CarsonDecapod/Loom_RP2040_Euro/RP2040_Euro_Power.kicad_pcb

## KiCad design RP2040_Euro_Power.kicad_pcb (2025-02-09)

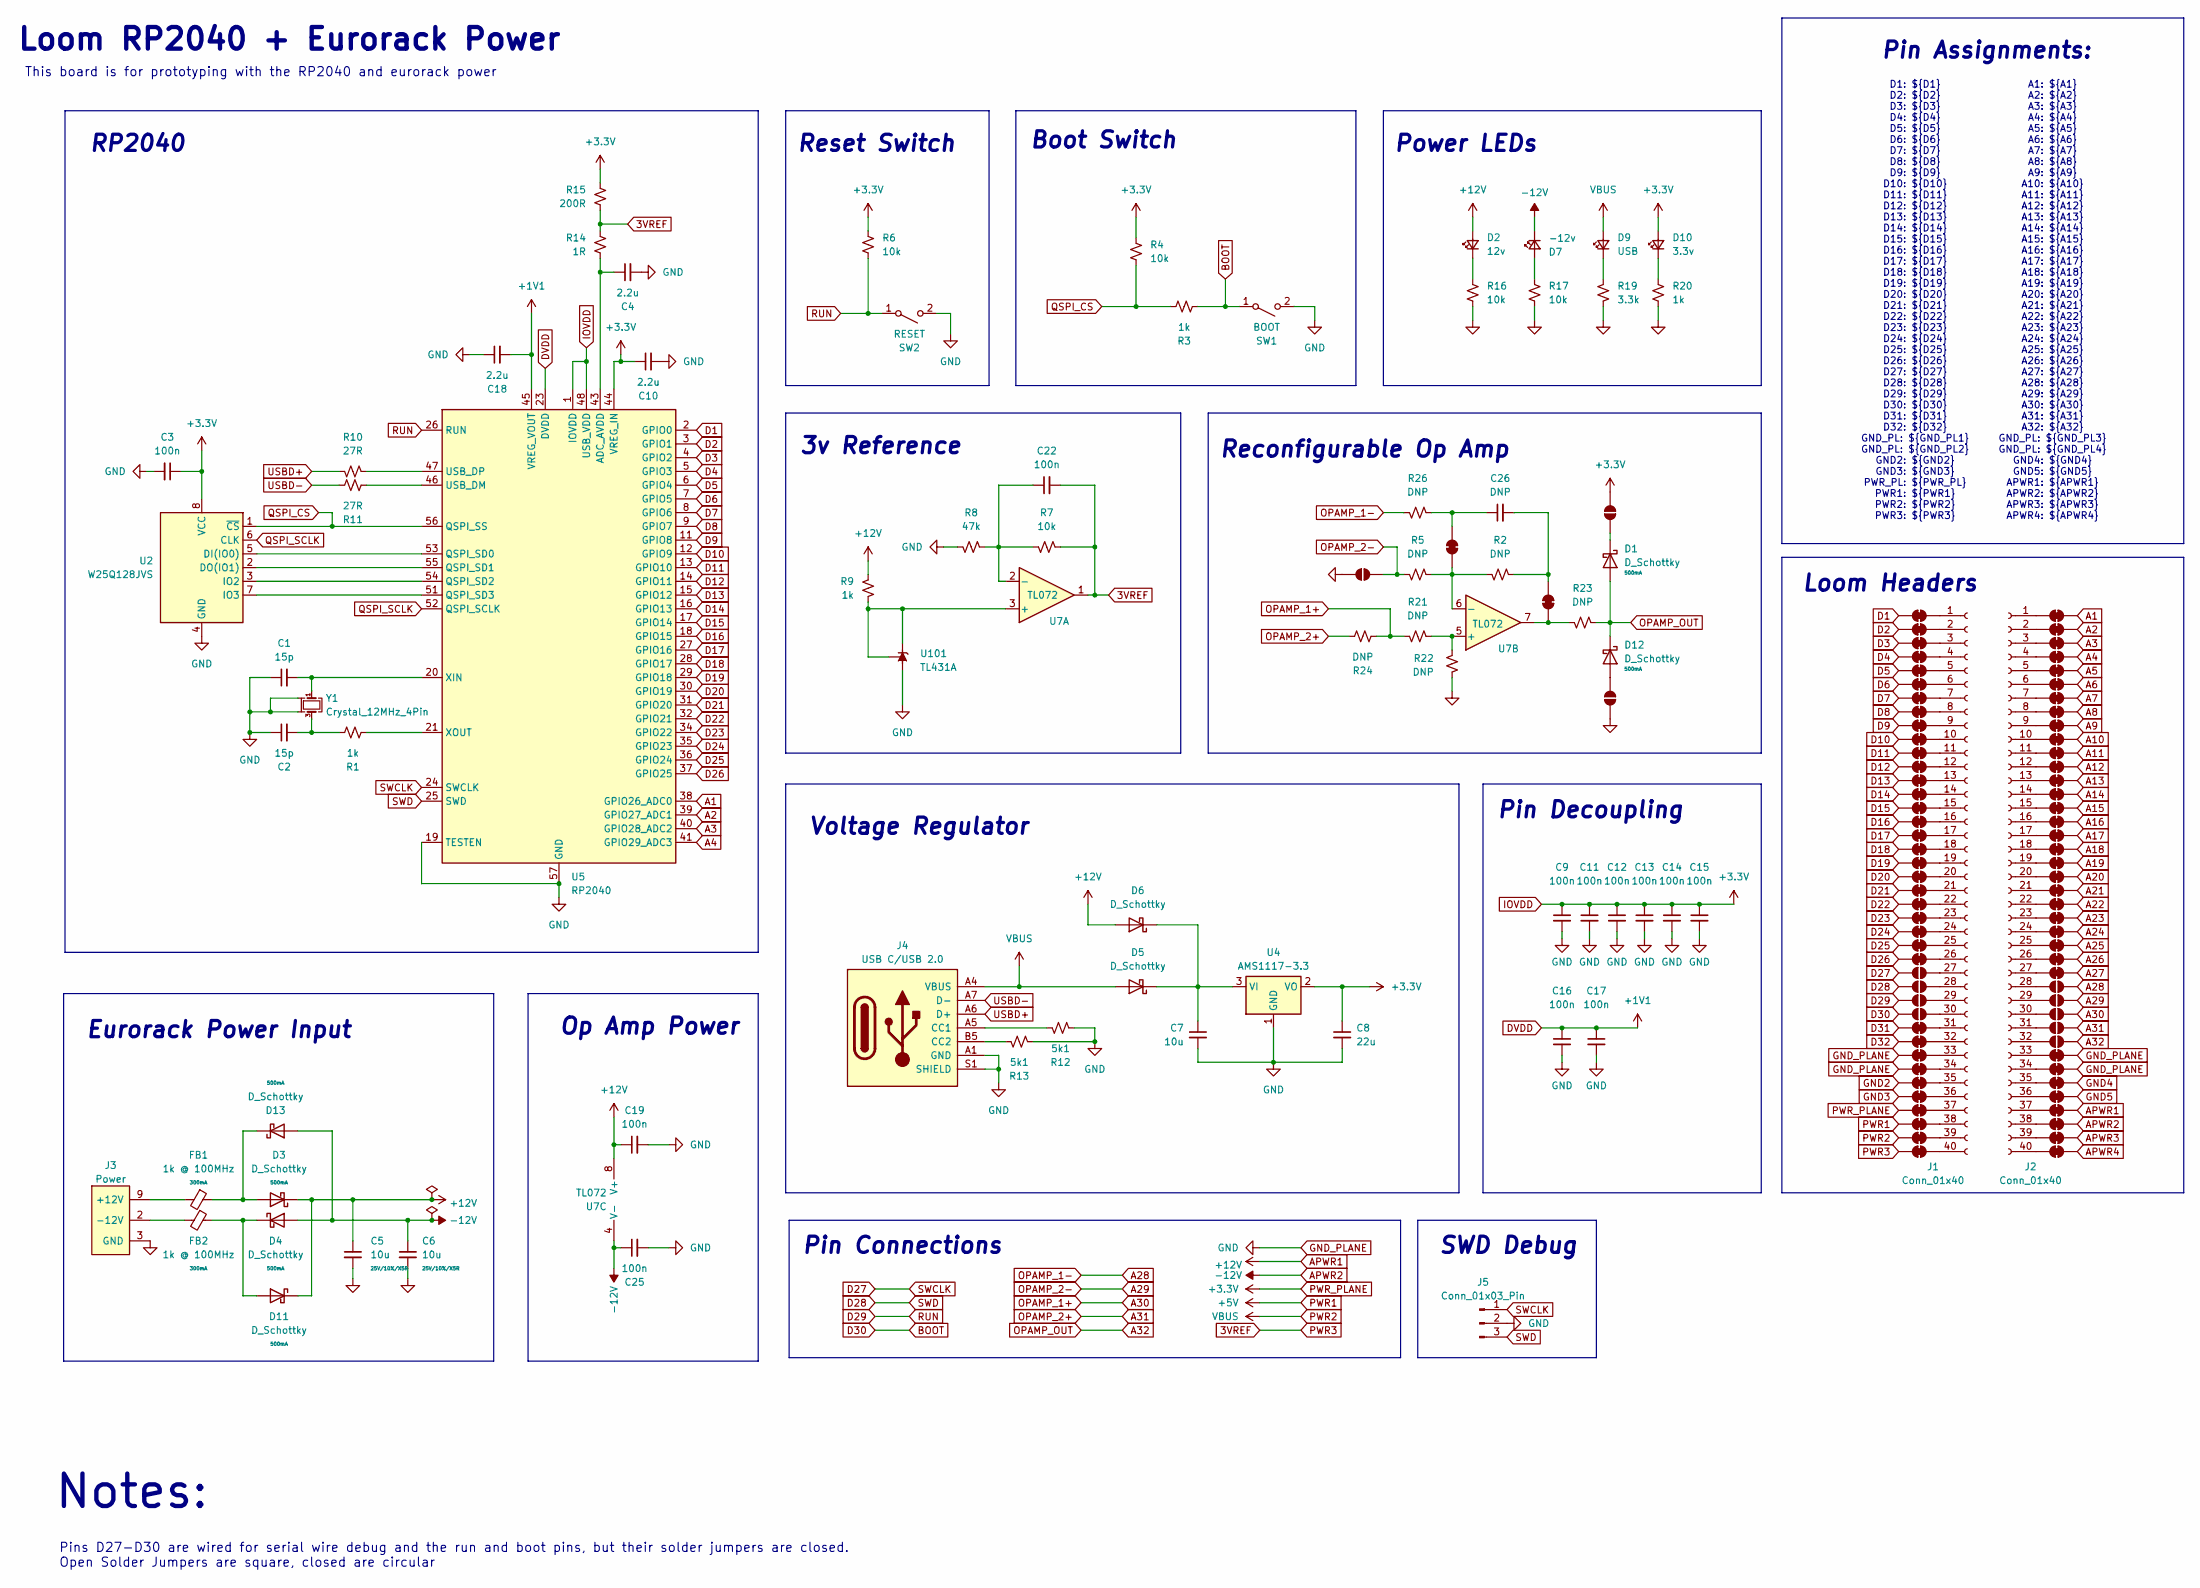
[picture p1: schematic RP2040_Euro_Power.kicad_sch]

Parts:
C1, C2: 15p; C_0603_HandSolder; Rating 25V/10%/C0G; MPN CL10C150JB8NNNC; LCSC C1644
C3, C9, C11, C12, C13, C14, C15, C16, C17, C19, C22, C25: 100n; C_0603_HandSolder; Rating 25V/10%/C0G; MPN CC0603KRX7R9BB104; LCSC C14663
C4, C10, C18: 2.2u; C_0603_HandSolder; Rating 25V/10%/C0G; MPN CL10A225KO8NNNC; LCSC C23630
C5, C6: 10u; C_0805_HandSolder; Rating 25V/10%/X5R; MPN CL21A106KAYNNNE; DigiKey 490-16824-1-ND
C7: 10u; C_0805_HandSolder; Rating 25V/10%/C0G; MPN CL21A106KAYNNNE; LCSC C15850
C8: 22u; C_0805_HandSolder; Rating 25V/10%/C0G; MPN CL21A226MAQNNNE; LCSC C45783
C26: DNP; C_0603_HandSolder; Rating 25V/10%; mpn C1608X7R1E104K080AA
D1, D3, D4, D11, D12, D13: D_Schottky; D_SMA; Rating 500mA; MPN SS14; DigiKey 1727-3876-1-ND
D2: 12v; LED_0805_2012Metric; MPN KT-0805G; LCSC C2297
D5, D6: D_Schottky; D_SMA; MPN SS14; LCSC C2480
D7: -12v; LED_0805_2012Metric; MPN KT-0805G; LCSC C2297
D9: USB; LED_0805_2012Metric; MPN KT-0805G; LCSC C2297
D10: 3.3v; LED_0805_2012Metric; MPN KT-0805G; LCSC C2297
FB1, FB2: 1k @ 100MHz; L_0603_HandSolder; Rating 300mA; MPN GZ1608D601TF; DigiKey 490-5212-1-ND
J1, J2: Conn_01x40; PinHeader_1x40_P2.54mm_Vertical
J3: Power; Eurorack_Power_2x5_Shrouded_Lock_LongPads; MPN 302-S101
J4: USB C/USB 2.0; USB_C_Receptacle_GCT_USB4105-xx-A_16P_TopMnt_Horizontal; MPN TYPE-C 16PIN 2MD(073); LCSC C2765186
J5: Conn_01x03_Pin; PinHeader_1x03_P2.54mm_Vertical
JP1, JP201: Jumper_Closed; SolderJumper-2_P1.3mm_Bridged_RoundedPad1.0x1.5mm
JP2, JP3, JP4, JP127, JP128, JP129, JP130, JP168, JP169, JP170, JP171, JP172: SolderJumper_2_Open; SolderJumper-2_P1.3mm_Open_Pad1.0x1.5mm
JP101, JP102, JP103, JP104, JP105, JP106, JP107, JP108, JP109, JP110, JP111, JP112, JP113, JP114, JP115, JP116, JP117, JP118, JP119, JP120, JP121, JP122, JP123, JP124, JP125, JP126, JP131, JP132, JP133, JP134, JP135, JP136, JP137, JP138, JP139, JP140, JP141, JP142, JP143, JP144, JP145, JP146, JP147, JP148, JP149, JP150, JP151, JP152, JP153, JP154, JP155, JP156, JP157, JP158, JP159, JP160, JP161, JP162, JP163, JP164, JP165, JP166, JP167, JP173, JP174, JP175, JP176, JP177, JP178, JP179, JP180: SolderJumper-2_P1.3mm_Bridged_RoundedPad1.0x1.5mm
R1, R3, R9, R20: 1k; R_0603_HandSolder; Rating 100mW/1%/Thin; MPN 0603WAF1001T5E; LCSC C21190
R2, R5, R21, R22, R23, R24, R26: DNP; R_0603_HandSolder; Rating 100mW/1%/Thin
R4, R6, R7, R16, R17: 10k; R_0603_HandSolder; Rating 100mW/1%/Thin; MPN 0603WAF1002T5E; LCSC C25804
R8: 47k; R_0603_HandSolder; Rating 100mW/1%/Thin; MPN 0603WAF4702T5E; LCSC C25819
R10, R11: 27R; R_0603_HandSolder; Rating 100mW/1%/Thin; MPN 0603WAF270JT5E; LCSC C25190
R12, R13: 5k1; R_0603_HandSolder; Rating 100mW/1%/Thin; MPN 0603WAF5101T5E; LCSC C23186
R14: 1R; R_0603_HandSolder; Rating 100mW/1%/Thin; MPN 0603WAF100KT5E; LCSC C22936
R15: 200R; R_0603_HandSolder; Rating 100mW/1%/Thin; MPN 0603WAF2000T5E; LCSC C8218
R19: 3.3k; R_0603_HandSolder; Rating 100mW/1%/Thin; MPN 0603WAF3301T5E; LCSC C22978
SW1: BOOT; SW-SMD_TS24CA; MPN TS24CA; LCSC C393942
SW2: RESET; SW-SMD_TS24CA; MPN TS24CA; LCSC C393942
U2: W25Q128JVS; SOIC-8_5.23x5.23mm_P1.27mm; MPN W25Q128JVSIQ; LCSC C97521
U4: AMS1117-3.3; SOT-223-3_TabPin2; MPN AMS1117-3.3; LCSC C6186
U5: RP2040; QFN-56-1EP_7x7mm_P0.4mm_EP3.2x3.2mm; MPN RP2040; LCSC C2040
U7: TL072; SOIC-8_3.9x4.9mm_P1.27mm; MPN TL072CDT; LCSC C6961
U101: TL431A; SOT-23; Rating 1%; MPN TL431BSA-7, TL431AQDBZR,215;; DigiKey 1727-4260-1-ND
Y1: Crystal_12MHz_4Pin; Crystal_SMD_Abracon_ABM8G-4Pin_3.2x2.5mm; MPN ABM8-272-T3; LCSC C20625731

Connections:
3VREF: C22.2, JP140.2 (B), R7.2, R14.1, R15.2, U7.1
A1: JP141.1 (A), U5.38 (GPIO26_ADC0)
A2: JP142.1 (A), U5.39 (GPIO27_ADC1)
A3: JP143.1 (A), U5.40 (GPIO28_ADC2)
A4: JP144.1 (A), U5.41 (GPIO29_ADC3)
A5: JP145.1 (A)
A6: JP146.1 (A)
A7: JP147.1 (A)
A8: JP148.1 (A)
A9: JP149.1 (A)
A10: JP150.1 (A)
A11: JP151.1 (A)
A12: JP152.1 (A)
A13: JP153.1 (A)
A14: JP154.1 (A)
A15: JP155.1 (A)
A16: JP156.1 (A)
A17: JP157.1 (A)
A18: JP158.1 (A)
A19: JP159.1 (A)
A20: JP160.1 (A)
A21: JP161.1 (A)
A22: JP162.1 (A)
A23: JP163.1 (A)
A24: JP164.1 (A)
A25: JP165.1 (A)
A26: JP166.1 (A)
A27: JP167.1 (A)
A28: JP168.2 (B), R26.1
A29: JP2.2 (B), JP169.2 (B), R5.1
A30: JP170.2 (B), R21.1, R24.2
A31: JP171.2 (B), R24.1
A32: D1.2 (A), D12.1 (K), JP172.2 (B), R23.2
APWR1: C5.1, C19.1, D2.2 (A), D3.1 (K), D6.2 (A), D11.1 (K), JP177.1 (A), R9.1, U7.8 (V+)
APWR2: C6.1, C25.1, D4.2 (A), D7.1 (K), D13.2 (A), JP178.1 (A), U7.4 (V-)
APWR3: JP179.1 (A)
APWR4: JP180.1 (A)
BOOT: JP130.1 (A), R3.2, SW1.1 (A)
D1: JP101.2 (B), U5.2 (GPIO0)
D2: JP102.2 (B), U5.3 (GPIO1)
D3: JP103.2 (B), U5.4 (GPIO2)
D4: JP104.2 (B), U5.5 (GPIO3)
D5: JP105.2 (B), U5.6 (GPIO4)
D6: JP106.2 (B), U5.7 (GPIO5)
D7: JP107.2 (B), U5.8 (GPIO6)
D8: JP108.2 (B), U5.9 (GPIO7)
D9: JP109.2 (B), U5.11 (GPIO8)
D10: JP110.2 (B), U5.12 (GPIO9)
D11: JP111.2 (B), U5.13 (GPIO10)
D12: JP112.2 (B), U5.14 (GPIO11)
D13: JP113.2 (B), U5.15 (GPIO12)
D14: JP114.2 (B), U5.16 (GPIO13)
D15: JP115.2 (B), U5.17 (GPIO14)
D16: JP116.2 (B), U5.18 (GPIO15)
D17: JP117.2 (B), U5.27 (GPIO16)
D18: JP118.2 (B), U5.28 (GPIO17)
D19: JP119.2 (B), U5.29 (GPIO18)
D20: JP120.2 (B), U5.30 (GPIO19)
D21: JP121.2 (B), U5.31 (GPIO20)
D22: JP122.2 (B), U5.32 (GPIO21)
D23: JP123.2 (B), U5.34 (GPIO22)
D24: JP124.2 (B), U5.35 (GPIO23)
D25: JP125.2 (B), U5.36 (GPIO24)
D26: JP126.2 (B), U5.37 (GPIO25)
D27: J5.1, JP127.1 (A), U5.24 (SWCLK)
D28: J5.3, JP128.1 (A), U5.25 (SWD)
D29: JP129.1 (A), R6.1, SW2.1 (A), U5.26 (RUN)
D31: JP131.2 (B)
D32: JP132.2 (B)
DVDD: C16.1, C17.1, C18.2, U5.23 (DVDD), U5.45 (VREG_VOUT), U5.50 (DVDD)
GND2: JP135.2 (B)
GND3: JP136.2 (B)
GND4: JP175.1 (A)
GND5: JP176.1 (A)
GND_PLANE: C1.1, C2.1, C3.2, C4.2, C5.2, C6.2, C7.2, C8.2, C9.2, C10.2, C11.2, C12.2, C13.2, C14.2, C15.2, C16.2, C17.2, C18.1, C19.2, C25.2, J3.3 (GND), J3.4 (GND), J3.5 (GND), J3.6 (GND), J3.7 (GND), J3.8 (GND), J4.A1 (GND), J4.A12 (GND), J4.B1 (GND), J4.B12 (GND), J4.S1 (SHIELD), J5.2, JP2.1 (A), JP4.1 (A), JP133.2 (B), JP134.2 (B), JP173.1 (A), JP174.1 (A), R8.1, R12.2, R13.2, R16.1, R17.1, R19.2, R20.2, R22.1, SW1.2 (B), SW2.2 (B), U2.4 (GND), U4.1 (GND), U5.19 (TESTEN), U5.57 (GND), U101.3 (A), Y1.2, Y1.4
IOVDD: C3.1, C8.1, C9.1, C10.1, C11.1, C12.1, C13.1, C14.1, C15.1, D10.2 (A), JP3.2 (B), JP137.2 (B), R4.2, R6.2, R15.1, U2.8 (VCC), U4.2 (VO), U5.1 (IOVDD), U5.10 (IOVDD), U5.22 (IOVDD), U5.33 (IOVDD), U5.42 (IOVDD), U5.44 (VREG_IN), U5.48 (USB_VDD), U5.49 (IOVDD)
unnamed: C2.2, R1.1, Y1.3
unnamed: D1.1 (K), JP3.1 (A)
unnamed: D2.1 (K), R16.2
unnamed: C7.1, D5.1 (K), D6.1 (K), U4.3 (VI)
unnamed: D7.2 (A), R17.2
unnamed: D9.1 (K), R19.1
unnamed: D10.1 (K), R20.1
unnamed: D4.1 (K), D11.2 (A), FB2.1
unnamed: D12.2 (A), JP4.2 (B)
unnamed: D3.2 (A), D13.1 (K), FB1.1
unnamed: FB1.2, J3.9 (+12V), J3.10 (+12V)
unnamed: FB2.2, J3.1 (-12V), J3.2 (-12V)
unnamed: J1.1, JP101.1 (A)
unnamed: J1.2, JP102.1 (A)
unnamed: J1.3, JP103.1 (A)
unnamed: J1.4, JP104.1 (A)
unnamed: J1.5, JP105.1 (A)
unnamed: J1.6, JP106.1 (A)
unnamed: J1.7, JP107.1 (A)
unnamed: J1.8, JP108.1 (A)
unnamed: J1.9, JP109.1 (A)
unnamed: J1.10, JP110.1 (A)
unnamed: J1.11, JP111.1 (A)
unnamed: J1.12, JP112.1 (A)
unnamed: J1.13, JP113.1 (A)
unnamed: J1.14, JP114.1 (A)
unnamed: J1.15, JP115.1 (A)
unnamed: J1.16, JP116.1 (A)
unnamed: J1.17, JP117.1 (A)
unnamed: J1.18, JP118.1 (A)
unnamed: J1.19, JP119.1 (A)
unnamed: J1.20, JP120.1 (A)
unnamed: J1.21, JP121.1 (A)
unnamed: J1.22, JP122.1 (A)
unnamed: J1.23, JP123.1 (A)
unnamed: J1.24, JP124.1 (A)
unnamed: J1.25, JP125.1 (A)
unnamed: J1.26, JP126.1 (A)
unnamed: J1.27, JP127.2 (B)
unnamed: J1.28, JP128.2 (B)
unnamed: J1.29, JP129.2 (B)
unnamed: J1.30, JP130.2 (B)
unnamed: J1.31, JP131.1 (A)
unnamed: J1.32, JP132.1 (A)
unnamed: J1.33, JP133.1 (A)
unnamed: J1.34, JP134.1 (A)
unnamed: J1.35, JP135.1 (A)
unnamed: J1.36, JP136.1 (A)
unnamed: J1.37, JP137.1 (A)
unnamed: J1.38, JP138.1 (A)
unnamed: J1.39, JP139.1 (A)
unnamed: J1.40, JP140.1 (A)
unnamed: J2.1, JP141.2 (B)
unnamed: J2.2, JP142.2 (B)
unnamed: J2.3, JP143.2 (B)
unnamed: J2.4, JP144.2 (B)
unnamed: J2.5, JP145.2 (B)
unnamed: J2.6, JP146.2 (B)
unnamed: J2.7, JP147.2 (B)
unnamed: J2.8, JP148.2 (B)
unnamed: J2.9, JP149.2 (B)
unnamed: J2.10, JP150.2 (B)
unnamed: J2.11, JP151.2 (B)
unnamed: J2.12, JP152.2 (B)
unnamed: J2.13, JP153.2 (B)
unnamed: J2.14, JP154.2 (B)
unnamed: J2.15, JP155.2 (B)
unnamed: J2.16, JP156.2 (B)
unnamed: J2.17, JP157.2 (B)
unnamed: J2.18, JP158.2 (B)
unnamed: J2.19, JP159.2 (B)
unnamed: J2.20, JP160.2 (B)
unnamed: J2.21, JP161.2 (B)
unnamed: J2.22, JP162.2 (B)
unnamed: J2.23, JP163.2 (B)
unnamed: J2.24, JP164.2 (B)
unnamed: J2.25, JP165.2 (B)
unnamed: J2.26, JP166.2 (B)
unnamed: J2.27, JP167.2 (B)
unnamed: J2.28, JP168.1 (A)
unnamed: J2.29, JP169.1 (A)
unnamed: J2.30, JP170.1 (A)
unnamed: J2.31, JP171.1 (A)
unnamed: J2.32, JP172.1 (A)
unnamed: J2.33, JP173.2 (B)
unnamed: J2.34, JP174.2 (B)
unnamed: J2.35, JP175.2 (B)
unnamed: J2.36, JP176.2 (B)
unnamed: J2.37, JP177.2 (B)
unnamed: J2.38, JP178.2 (B)
unnamed: J2.39, JP179.2 (B)
unnamed: J2.40, JP180.2 (B)
unnamed: J4.A5 (CC1), R12.1
unnamed: J4.B5 (CC2), R13.1
unnamed: JP1.1 (A), R2.1, R5.2, U7.6 (-)
unnamed: C26.1, JP1.2 (B), R26.2
unnamed: JP201.1 (A), R23.1, U7.7
unnamed: C26.2, JP201.2 (B), R2.2
unnamed: U2.5 (DI(IO0)), U5.53 (QSPI_SD0)
unnamed: U2.2 (DO(IO1)), U5.55 (QSPI_SD1)
unnamed: U2.3 (IO2), U5.54 (QSPI_SD2)
unnamed: U2.7 (IO3), U5.51 (QSPI_SD3)
unnamed: C4.1, R14.2, U5.43 (ADC_AVDD)
unnamed: R11.1, U5.46 (USB_DM)
unnamed: R10.1, U5.47 (USB_DP)
unnamed: C1.2, U5.20 (XIN), Y1.1
unnamed: R1.2, U5.21 (XOUT)
unnamed: C22.1, R7.1, R8.2, U7.2 (-)
unnamed: R21.2, R22.2, U7.5 (+)
unnamed: R9.2, U7.3 (+), U101.1 (K), U101.2 (REF)
PWR1: JP138.2 (B)
PWR2: D5.2 (A), D9.2 (A), J4.A4 (VBUS), J4.A9 (VBUS), J4.B4 (VBUS), J4.B9 (VBUS), JP139.2 (B)
QSPI_CS: R3.1, R4.1, U2.1 (~CS), U5.56 (QSPI_SS)
QSPI_SCLK: U2.6 (CLK), U5.52 (QSPI_SCLK)
USBD+: J4.A6 (D+), J4.B6 (D+), R10.2
USBD-: J4.A7 (D-), J4.B7 (D-), R11.2

Notes on the sheet:
Pin Assignments:
A1: ${A1} A2: ${A2} A3: ${A3} A4: ${A4} A5: ${A5} A6: ${A6} A7: ${A7} A8: ${A8} A9: ${A9} A10: ${A10} A11: ${A11} A12: ${A12} A13: ${A13} A14: ${A14} A15: ${A15} A16: ${A16} A17: ${A17} A18: ${A18} A19: ${A19} A20: ${A20} A21: ${A21} A22: ${A22} A23: ${A23} A24: ${A24} A25: ${A25} A26: ${A26} A27: 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
Loom RP2040 + Eurorack Power
Power LEDs
Notes:
Reconfigurable Op Amp
RP2040
Reset Switch
This board is for prototyping with the RP2040 and eurorack power
D1: ${D1} D2: ${D2} D3: ${D3} D4: ${D4} D5: ${D5} D6: ${D6} D7: ${D7} D8: ${D8} D9: ${D9} D10: ${D10} D11: ${D11} D12: ${D12} D13: ${D13} D14: ${D14} D15: ${D15} D16: ${D16} D17: ${D17} D18: ${D18} D19: ${D19} D20: ${D20} D21: ${D21} D22: ${D22} D23: ${D23} D24: ${D24} D25: ${D25} D26: ${D26} D27: 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
Eurorack Power Input
Pin Decoupling
Voltage Regulator
Loom Headers
SWD Debug
3v Reference
Boot Switch
Op Amp Power
Pins D27-D30 are wired for serial wire debug and the run and boot pins, but their solder jumpers are closed. Open Solder Jumpers are square, closed are circular
Pin Connections

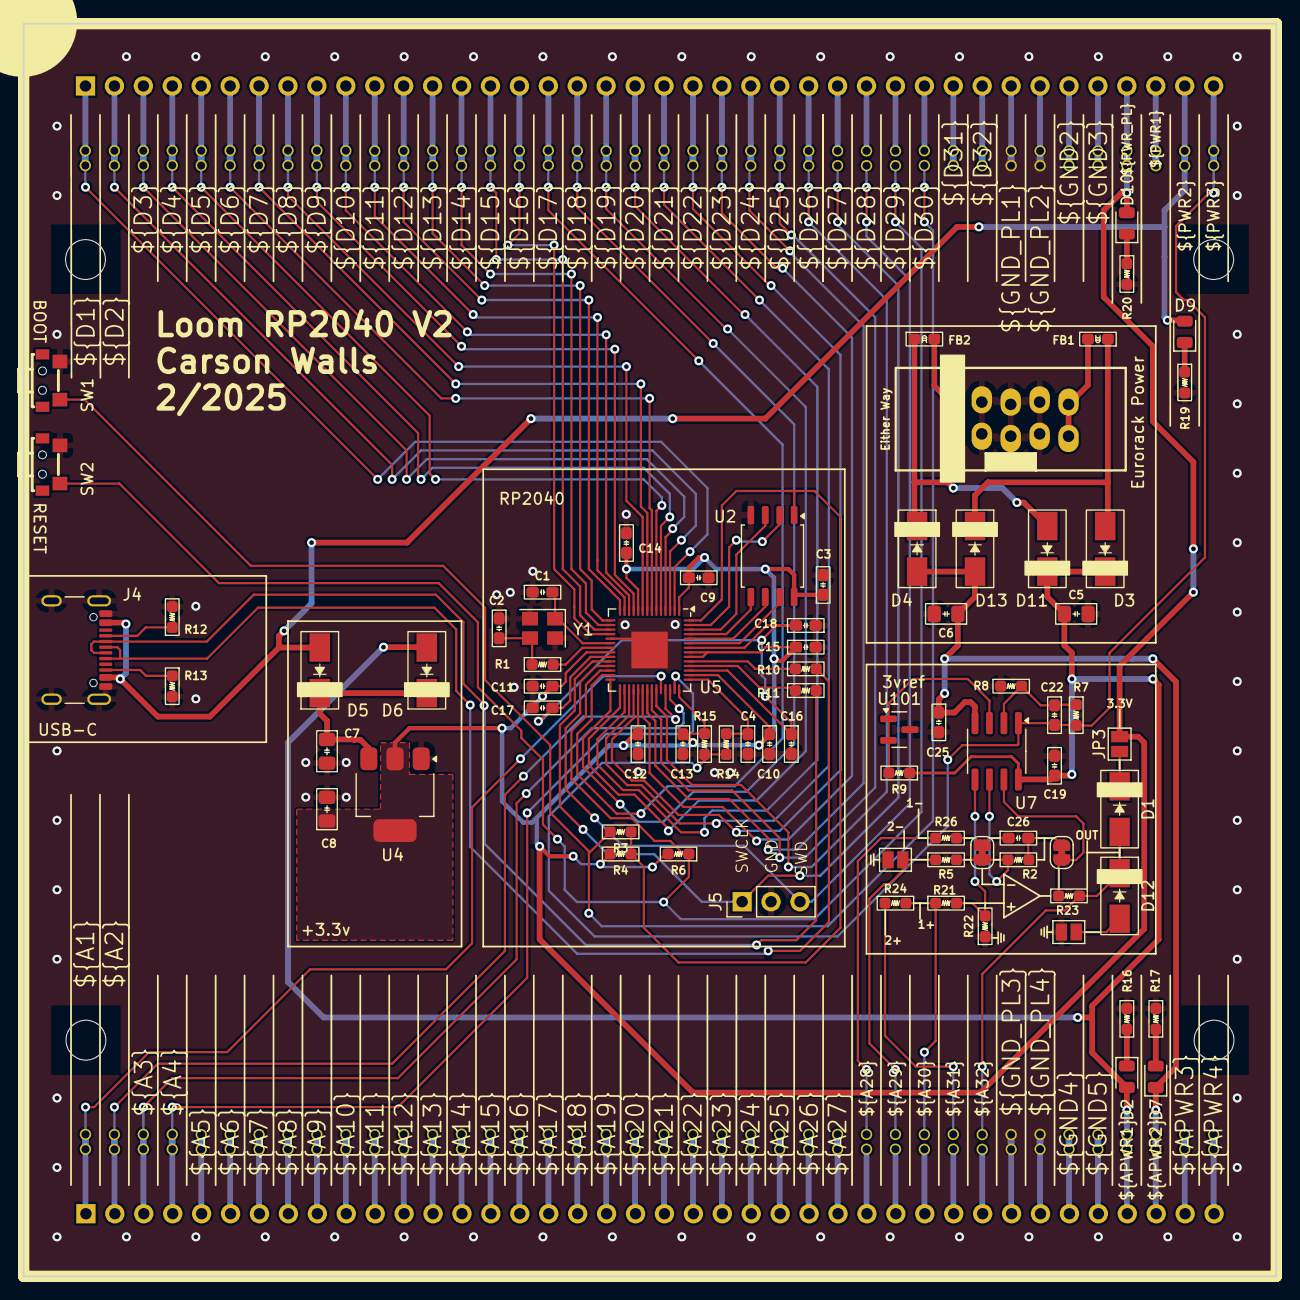
[picture p2: board RP2040_Euro_Power.kicad_pcb from above]

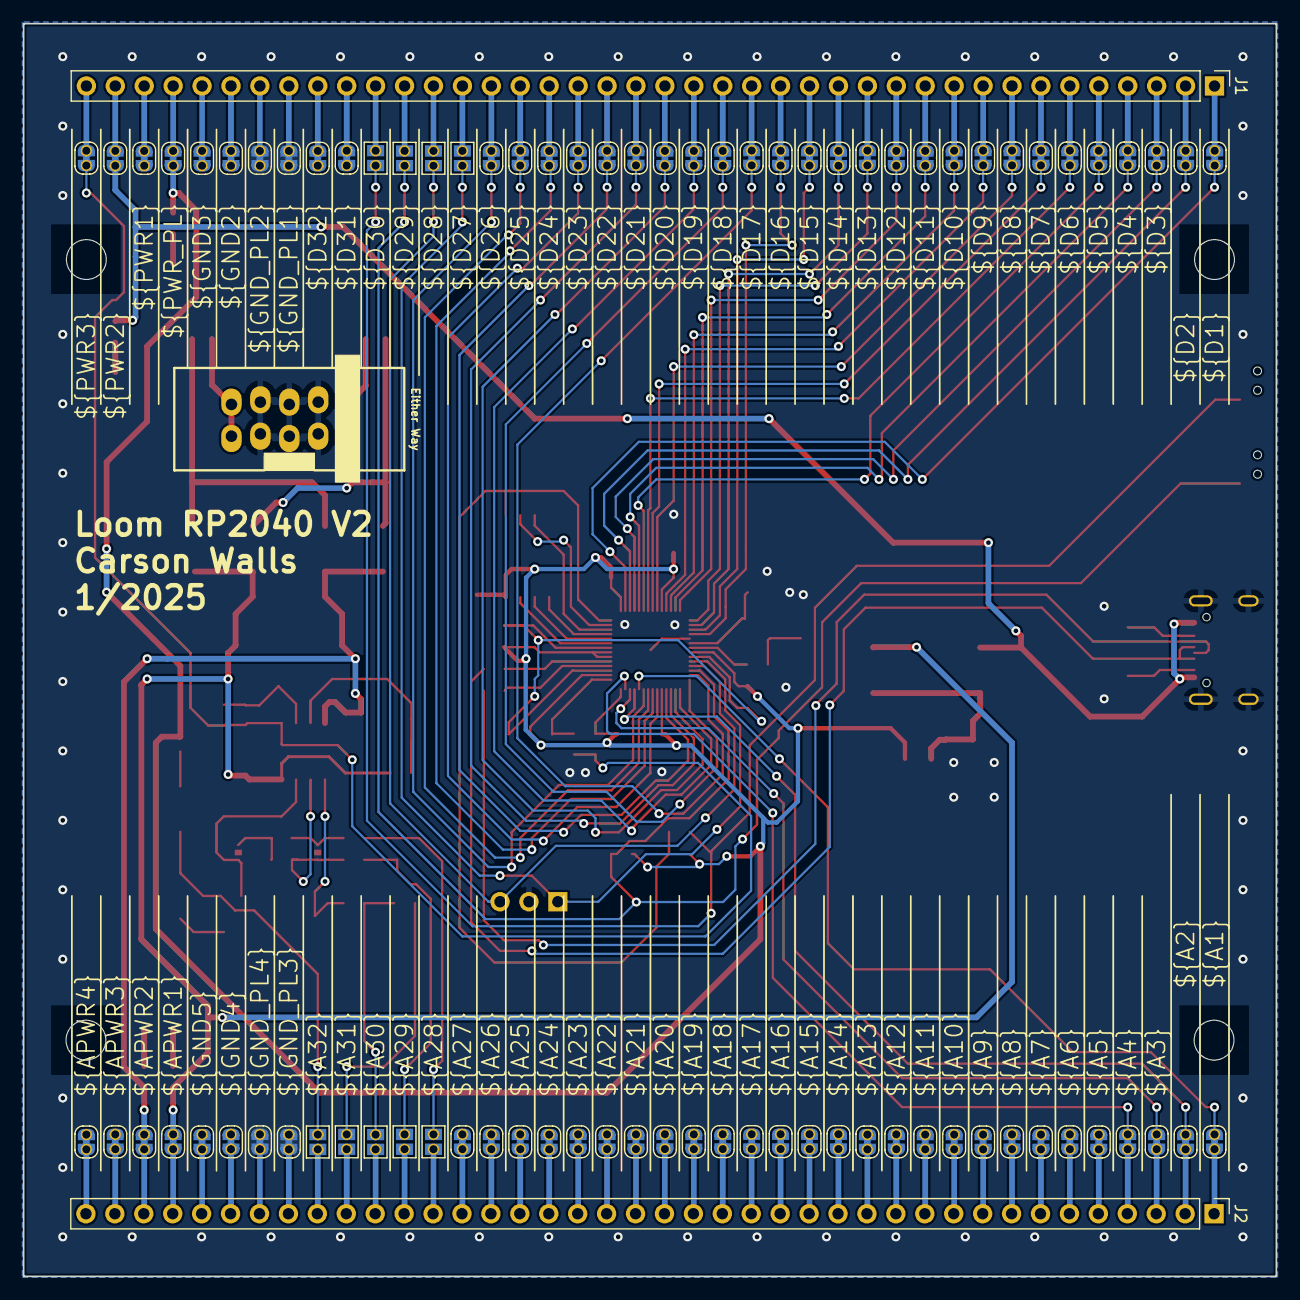
[picture p3: board RP2040_Euro_Power.kicad_pcb from below]

Board: 2 copper layers, 110.0 x 110.0 mm, 158 parts (82 on the bottom side), 160 nets.
