CarsonDecapod/Loom_RP2040_Euro/(commit log)

2024-07-04 Schematic ready to start board layout.
    [RP2040_Euro_Power.kicad_pcb, RP2040_Euro_Power.kicad_sch]
2024-07-05 half of the parts placed on board
    [RP2040_Euro_Power.kicad_pcb, RP2040_Euro_Power.kicad_sch]
2024-07-05 all parts placed on board
    [RP2040_Euro_Power.kicad_pcb, RP2040_Euro_Power.kicad_sch]
2024-07-05 Board mostly layed out, ready to start routing
    [RP2040_Euro_Power.kicad_pcb, RP2040_Euro_Power.kicad_sch]
2024-07-06 Second op amp used. Ready for routing
    [RP2040_Euro_Power.kicad_pcb, RP2040_Euro_Power.kicad_sch]
2024-07-07 First draft of routing done. Still need to clean everything up, but it passes DRC.
    [RP2040_Euro_Power.kicad_pcb]
2024-08-22 Loom RP2040 V1 Ordered
    [BOM.csv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]
2024-12-30 Moved buttons to the side, disconnected opamp
    [RP2040_Euro_Power.kicad_pcb, RP2040_Euro_Power.kicad_sch]
2025-01-08 RP2040 Updated
    Moved buttons to side, removed 5v LDO
2025-01-10 Version 2 Basically ready to order
    [RP2040_Euro_Power.kicad_pcb, RP2040_Euro_Power.kicad_sch]
2025-02-09 Version 2 ready to order
    [BOM.csv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]
